triinyti/Guitar_interface/README.md

# Guitar_interface
Custom designed guitar interface for 48kHz/24 bit audio transmission via UAC (USB Audio Class) and mic output.
