triinyti/Guitar_interface/simulation/lin_per_loudness_poti_sim.asc

120: res; 1.5k
I1: current; 1
R1: res; {Rother}
R2: res; {Rtap}
R4: res; 470
V1: voltage; 1
Named nets: 0
.param Rother = 10k - Rtap + 0.001
.step param Rtap 0.01 10k 10
.op
;.tf
