triinyti/Guitar_interface/simulation/opamp_audio_pipeline.asc

100: res; 100
C1: cap; 470µ
C2: cap; 100n
C3: cap; 100n
C4: cap; 560n; Rser=0.001
C5: cap; 68n
C6: cap; 330n
C7: cap; 47n
C8: cap; 10µ
C9: cap; 1µ
C10: cap; 1n
C11: cap; 470p
C12: cap; 280p
C13: cap; 560p
C14: cap; 100µ
C15: cap; 10n
C16: cap; 100n
C17: cap; 10µ
C18: cap; 1µ
C19: cap; 1n
D1: schottky; BAT54
D2: schottky; BAT54
D3: schottky; BAT54
D4: schottky; BAT54
D5: diode
D7: LED
I1: current; ""; AC 1
M1: nmos; BSP89
R1: res; 1k
R2: res; {Rin1}
R3: res; 100
R4: res; 2.2k
R5: res; 49k
R6: res; 1k
R7: res; 1k
R8: res; 49k
R9: res; 10k
R10: res; 10k
R11: res; 2.2k
R12: res; 1k
R13: res; 0.18k
R14: res; 0.18k
R15: res; {Rin2}
R16: res; 0.18k
R17: res; 0.18k
R18: res; 0.18k
R19: res; {Rin3}
R20: res; 0.18k
R21: res; 1k
R22: res; {Rout1}
R23: res; {Rout2}
R24: res; {Rout3}
R25: res; 1Meg
R26: res; {Rout4}
R27: res; {Rin4}
R28: res; 100k
R29: res; 22k
R30: res; 1k
R31: res; 1k
R32: res; 15k
R33: res; 100
R34: res; 130
R35: res; 1.8Meg
R36: res; 10k
R37: res; 20k
R38: res; 20k
R39: res; 10k
R40: res; 470
R41: res; 1.5k
R42: res; 10k
R43: res; 1Meg
R44: res; 75k
R45: res; 10.2k
Rbase: res; 100
U1: OPAx134
U2: OPAx134
U4: OPAx134
U5: LTC1440
U6: OPAx134
U7: OPAx134
U9: OPAx134
U10: OPAx134
U12: OPAx134
V1: voltage; SINE(0 2 {fq} 0 0 0); AC 0.05
V2: voltage; 5
V3: voltage; 5
V4: voltage; 2
V5: voltage; 5
V6: voltage; SINE(0 0.04 1000)
V7: voltage; SINE(0 0.04 10000)
V9: voltage; 3.3
Named nets: out, 0, vp, vn, clamp, attenuator, 3.3, clipping_detection, adc_buffer, adc, vadc
.ac lin 100000 0.001 20000
.tran 0 {t_stop} {t_start} 0.001
remove when measuring output impedance
.param Rout1 = maxval - Rin1 + 0.001
.param Rout2 = maxval - Rin2 + 0.001
.param Rout3 = maxval - Rin3 + 0.001
.param maxval = 10.0000k
.param Rin1 = 5k
.param Rin2 = 5k
.param Rin3 = 5k
Input buffer with 1Meg Ohm 
resistor in order not to load the guitar pickups
.param fq = 20
.param Rout4 = 10k - Rin4 + 0.001
.param Rin4=10k
Clipping detection: charge RC-network R29//C8 when clipping. 
Use voltage to trigger a LED to light up.
Precision voltage clamp for a couple of mV
3 band active equilizer
Attenuation for the aux mic input
.param t_start = 0
.param t_stop = t_start + t_show
.param t_show = 0.5
connecting this makes the simulation stop working because something
makes it take extremly long. Should work in theory and simulations 
before adding the adc section showed good results.
use fdv301n
