triinyti/Guitar_interface/simulation/pmos_en_vdd.asc

M1: pmos; Si1013
R1: res; 330
R2: res; 10k
R3: res; 100
V1: voltage; 3.3
V2: voltage; PULSE(3.3 0 1 10n 10n 5 0 1)
Named nets: 0
.tran 0 10 0
