triinyti/Guitar_interface/simulation/powersupply_opamp.asc

C1: cap; 4.7µ
C2: cap; 4.7µ
C3: cap; 2.2n
C4: cap; 100n
C5: cap; 47p
C6: cap; 1n
C7: cap; 10µ; IC=0
C8: cap; 4.7µ
C9: cap; 100n
C10: cap; 2.2n
C11: cap; 1µ
C12: cap; 4.7µ; Rser=10m
C13: cap; 4.7µ
C14: cap; 10µ
C15: cap; 1n
C16: cap; 100n
C17: cap; 4.7µ; Rser=0.5
C18: cap; 22µ
C19: cap; 1µ
C20: cap; 1n
C21: cap; 10µ
C22: cap; 4.7µ
D1: schottky; MBR0520L
D2: schottky; MBR0520L
L1: ind; 22µ; Rser=250m
L2: ind; 22µ; Rser=250m
L3: ind; 22µ; Rser=250m
L4: ind; 22µ; Rser=250m
L5: FerriteBead; 230n; Ipk=4 Rser=0.02 Rpar=145 Cpar=6f
R1: res; 68k
R2: res; 10k
R3: res; 68k
R4: res; 30k
R5: res; 10k
R6: res; 126
R7: res; 68k
R8: res; 10k
R9: res; 68k
R10: res; 500
R11: res; 22
R12: res; 126
U1: LT3580
U2: LT1763
U3: LT3580
U4: LT1964-5
U5: LT1790-5
U6: LT1763-3.3
V1: voltage; 5
V2: voltage; PULSE(0 3.3 20m 10n 10n 1)
Named nets: 0, vout, vin, 5vopv, 5vadc, 3.3vdigital, -5vopv
.tran 0 100m 0 1e-4
