triinyti/Guitar_interface/schematic/guitar_interface/guitar_interface.kicad_pcb

## KiCad design schematic/guitar_interface/guitar_interface.kicad_pcb (2026-02-12)

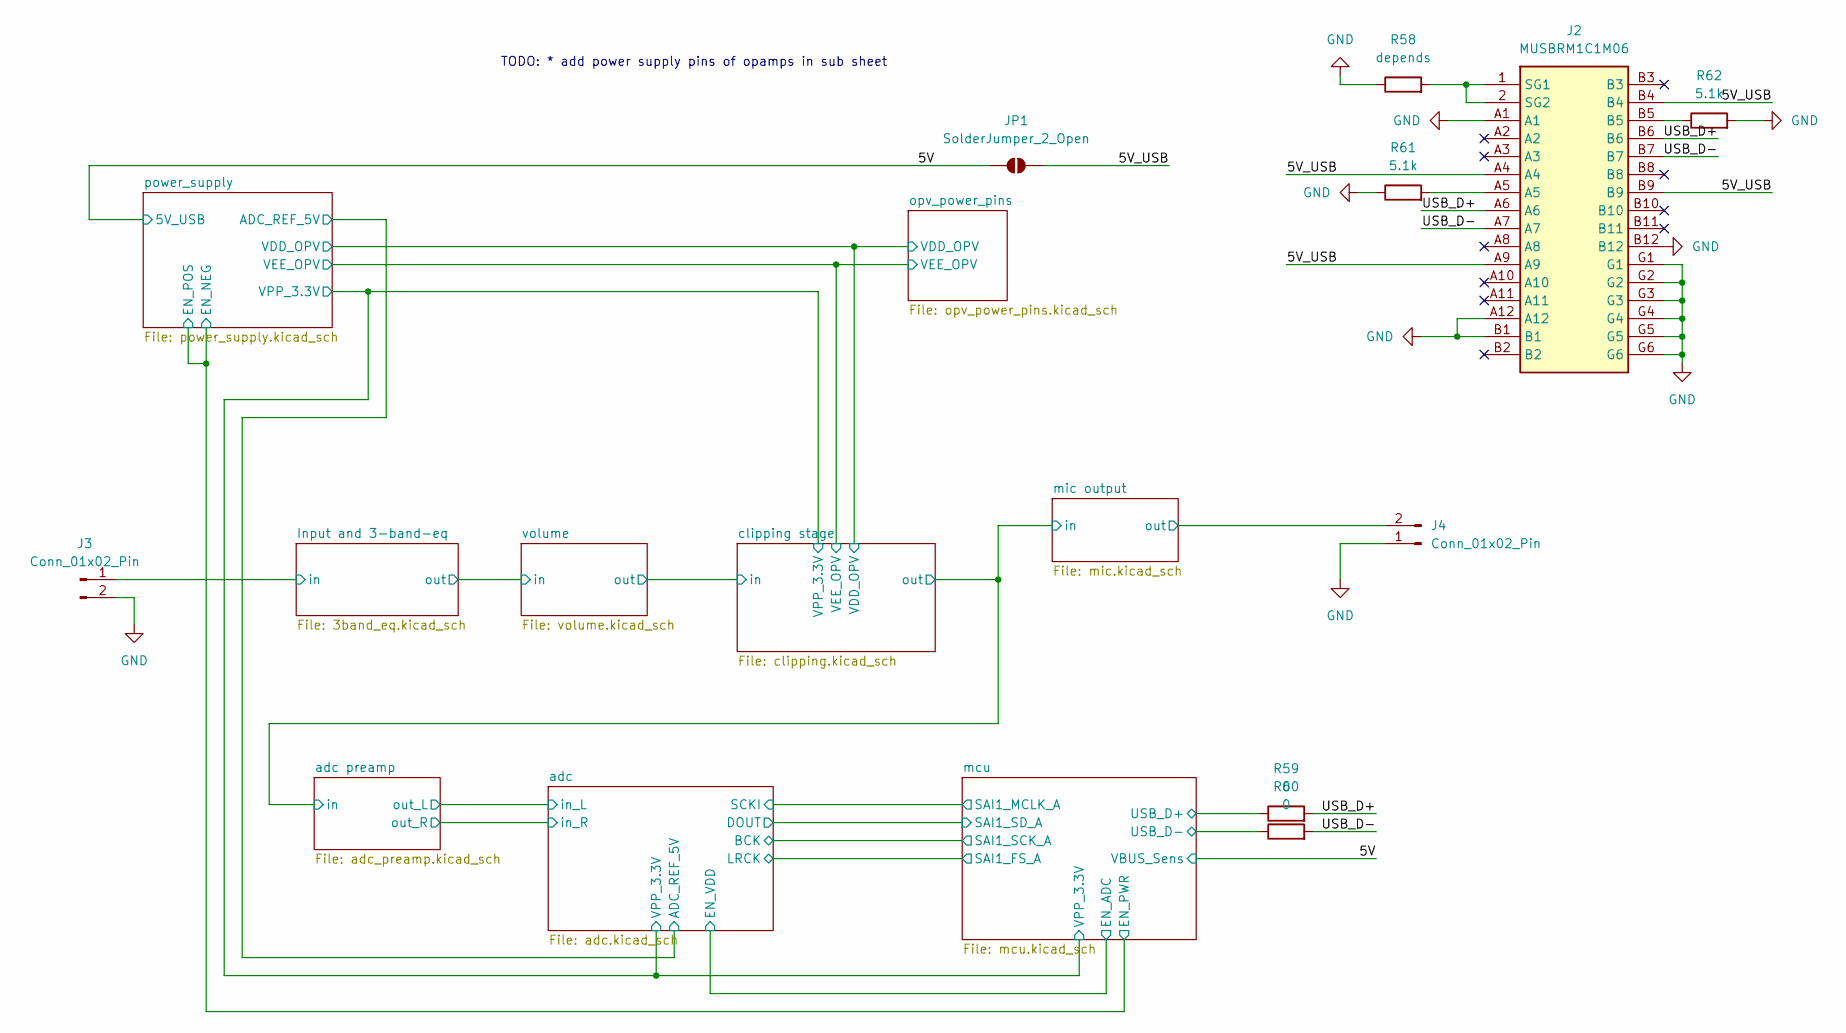
[picture p1: schematic guitar_interface.kicad_sch]

Parts:
J2: MUSBRM1C1M06; Mouser Part Number 523-MUSBRM1C1M06
J3, J4: Conn_01x02_Pin; PinSocket_1x02_P2.54mm_Vertical
JP1: SolderJumper_2_Open; SolderJumper-2_P1.3mm_Open_RoundedPad1.0x1.5mm
R58: depends; R_0603_1608Metric_Pad0.98x0.95mm_HandSolder
R59, R60: 0; R_0603_1608Metric_Pad0.98x0.95mm_HandSolder
R61, R62: 5.1k; R_0603_1608Metric_Pad0.98x0.95mm_HandSolder

Connections:
/5V: JP1.1 (A); also elsewhere on the board
/5V_USB: J2.A4, J2.A9, J2.B4, J2.B9, JP1.2 (B)
/Input and 3-band-eq/in: J3.1; also elsewhere on the board
/USB_D+: J2.A6, J2.B6, R59.2
/USB_D-: J2.A7, J2.B7, R60.2
/mcu/USB_D+: R59.1; also elsewhere on the board
/mcu/USB_D-: R60.1; also elsewhere on the board
/mic output/out: J4.2; also elsewhere on the board
GND: J2.A1, J2.A12, J2.B1, J2.B12, J2.G1, J2.G2, J2.G3, J2.G4, J2.G5, J2.G6, J3.2, J4.1, R58.1, R61.1, R62.2; also elsewhere on the board
unnamed: J2.A5, R61.2
unnamed: J2.B5, R62.1
unnamed: J2.1 (SG1), J2.2 (SG2), R58.2

Notes on the sheet:
TODO: * add power supply pins of opamps in sub sheet

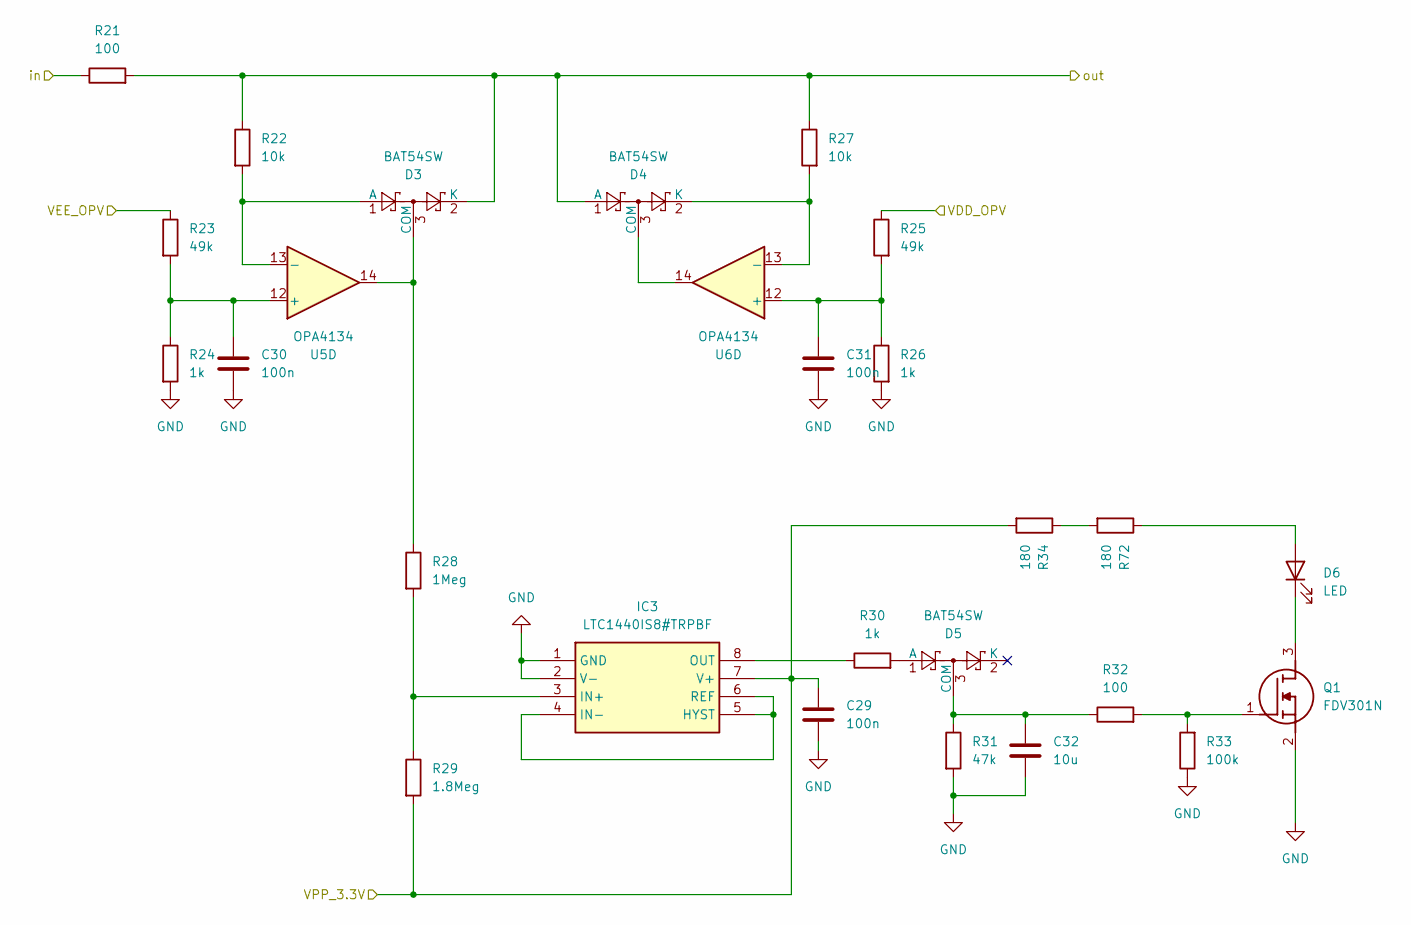
[picture p2: schematic clipping.kicad_sch]

Parts:
C29, C30, C31: 100n; C_0402_1005Metric_Pad0.74x0.62mm_HandSolder
C32: 10u; C_0603_1608Metric_Pad1.08x0.95mm_HandSolder
D3, D4, D5: BAT54SW; SOT-323_SC-70
D6: LED; LED_0603_1608Metric_Pad1.05x0.95mm_HandSolder
IC3: LTC1440IS8#TRPBF; SOIC127P599X175-8N; Mouser Part Number 584-LTC1440IS8#TRPBF
Q1: FDV301N; SOT96P237X111-3N; Mouser Part Number 512-FDV301N
R21, R32: 100; R_0603_1608Metric_Pad0.98x0.95mm_HandSolder
R22, R27: 10k; R_0603_1608Metric_Pad0.98x0.95mm_HandSolder
R23, R25: 49k; R_0603_1608Metric_Pad0.98x0.95mm_HandSolder
R24, R26, R30: 1k; R_0603_1608Metric_Pad0.98x0.95mm_HandSolder
R28: 1Meg; R_0603_1608Metric_Pad0.98x0.95mm_HandSolder
R29: 1.8Meg; R_0603_1608Metric_Pad0.98x0.95mm_HandSolder
R31: 47k; R_0603_1608Metric_Pad0.98x0.95mm_HandSolder
R33: 100k; R_0603_1608Metric_Pad0.98x0.95mm_HandSolder
R34, R72: 180; R_0603_1608Metric_Pad0.98x0.95mm_HandSolder
U5, U6: OPA4134; SOIC-14_3.9x8.7mm_P1.27mm

Connections:
/adc preamp/in: D3.2 (K), D4.1 (A), R21.2, R22.1, R27.1; also elsewhere on the board
/adc/VPP_3.3V: C29.1, IC3.7 (V+), R29.2, R34.2; also elsewhere on the board
/clipping stage/VDD_OPV: R25.1; also elsewhere on the board
/clipping stage/VEE_OPV: R23.1; also elsewhere on the board
/clipping stage/in: R21.1; also elsewhere on the board
GND: C29.2, C30.2, C31.2, C32.2, IC3.1 (GND), IC3.2 (V-), Q1.2 (S), R24.2, R26.2, R31.2, R33.1; also elsewhere on the board
unnamed: D3.1 (A), R22.2, U5.13 (-)
unnamed: D3.3 (COM), R28.1, U5.14
unnamed: D4.3 (COM), U6.14
unnamed: D4.2 (K), R27.2, U6.13 (-)
unnamed: D5.1 (A), R30.2
unnamed: C32.1, D5.3 (COM), R31.1, R32.1
unnamed: D6.2 (A), R72.1
unnamed: D6.1 (K), Q1.3 (D)
unnamed: IC3.4 (IN-), IC3.5 (HYST), IC3.6 (REF)
unnamed: IC3.3 (IN+), R28.2, R29.1
unnamed: IC3.8 (OUT), R30.1
unnamed: Q1.1 (G), R32.2, R33.2
unnamed: R34.1, R72.2
unnamed: C30.1, R23.2, R24.1, U5.12 (+)
unnamed: C31.1, R25.2, R26.1, U6.12 (+)

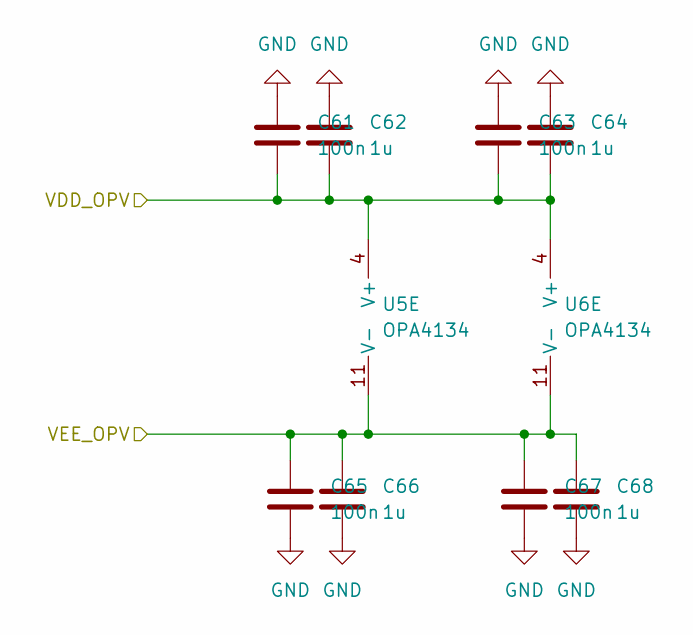
[picture p3: schematic opv_power_pins.kicad_sch]

Parts:
C61, C63, C65, C67: 100n; C_0402_1005Metric_Pad0.74x0.62mm_HandSolder
C62, C64, C66, C68: 1u; C_0603_1608Metric_Pad1.08x0.95mm_HandSolder
U5, U6: OPA4134; SOIC-14_3.9x8.7mm_P1.27mm

Connections:
/clipping stage/VDD_OPV: C61.2, C62.2, C63.2, C64.2, U5.4 (V+), U6.4 (V+); also elsewhere on the board
/clipping stage/VEE_OPV: C65.1, C66.1, C67.1, C68.1, U5.11 (V-), U6.11 (V-); also elsewhere on the board
GND: C61.1, C62.1, C63.1, C64.1, C65.2, C66.2, C67.2, C68.2; also elsewhere on the board

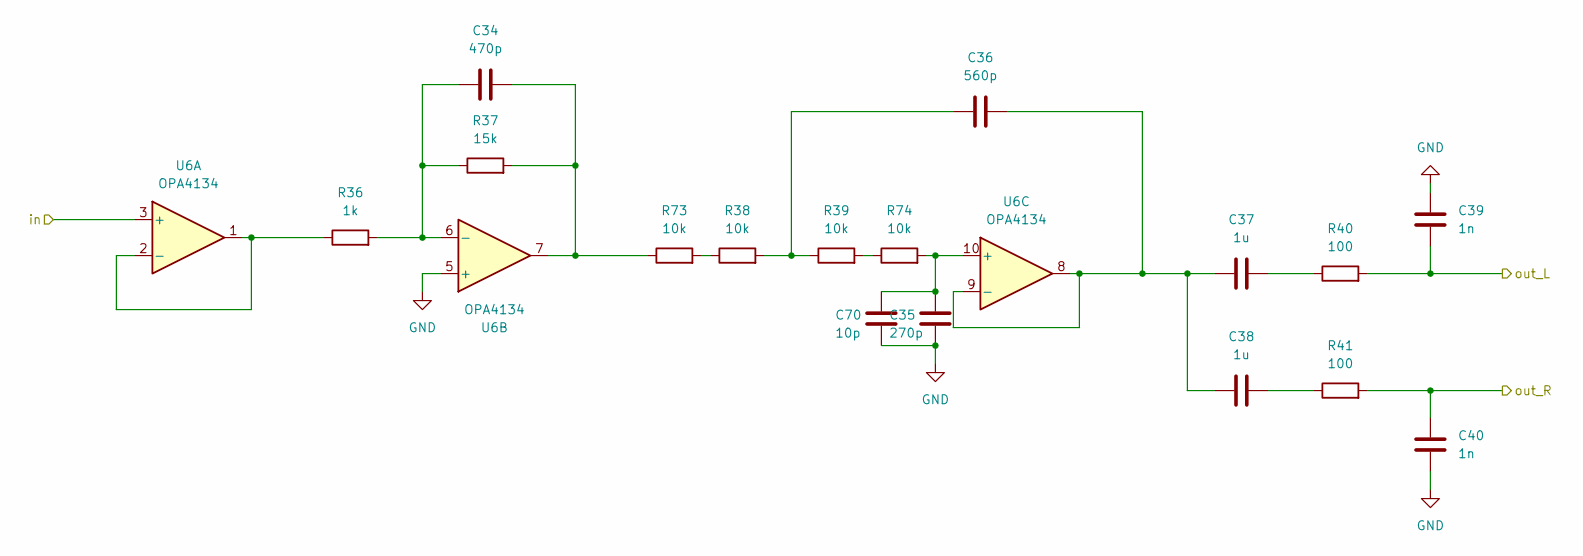
[picture p4: schematic adc_preamp.kicad_sch]

Parts:
C34: 470p; C_0603_1608Metric_Pad1.08x0.95mm_HandSolder
C35: 270p; C_0402_1005Metric_Pad0.74x0.62mm_HandSolder
C36: 560p; C_0805_2012Metric_Pad1.18x1.45mm_HandSolder
C37, C38: 1u; C_0603_1608Metric_Pad1.08x0.95mm_HandSolder
C39, C40: 1n; C_0402_1005Metric_Pad0.74x0.62mm_HandSolder
C70: 10p; C_0603_1608Metric_Pad1.08x0.95mm_HandSolder
R36: 1k; R_0603_1608Metric_Pad0.98x0.95mm_HandSolder
R37: 15k; R_0603_1608Metric_Pad0.98x0.95mm_HandSolder
R38, R39, R73, R74: 10k; R_0603_1608Metric_Pad0.98x0.95mm_HandSolder
R40, R41: 100; R_0603_1608Metric_Pad0.98x0.95mm_HandSolder
U6: OPA4134; SOIC-14_3.9x8.7mm_P1.27mm

Connections:
/adc preamp/in: U6.3 (+); also elsewhere on the board
/adc preamp/out_L: C39.1, R40.2; also elsewhere on the board
/adc preamp/out_R: C40.2, R41.2; also elsewhere on the board
GND: C35.2, C39.2, C40.1, C70.2, U6.5 (+); also elsewhere on the board
unnamed: C34.2, R37.2, R73.1, U6.7
unnamed: C36.1, R38.2, R39.1
unnamed: C37.2, R40.1
unnamed: C38.2, R41.1
unnamed: R38.1, R73.2
unnamed: R39.2, R74.1
unnamed: R36.1, U6.1, U6.2 (-)
unnamed: C34.1, R36.2, R37.1, U6.6 (-)
unnamed: C35.1, C70.1, R74.2, U6.10 (+)
unnamed: C36.2, C37.1, C38.1, U6.8, U6.9 (-)

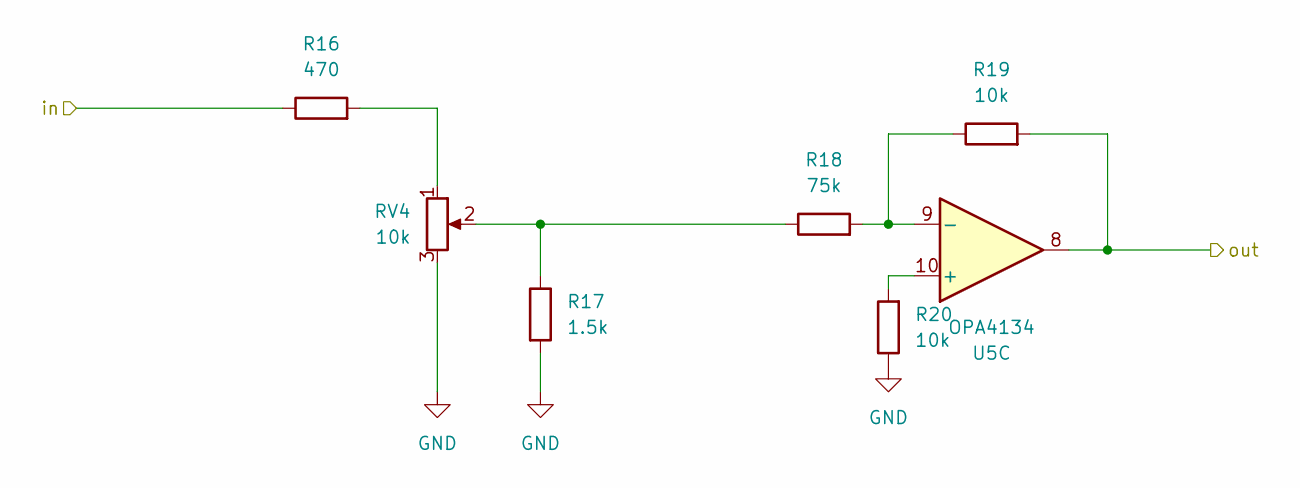
[picture p5: schematic volume.kicad_sch]

Parts:
R16: 470; R_0603_1608Metric_Pad0.98x0.95mm_HandSolder
R17: 1.5k; R_0603_1608Metric_Pad0.98x0.95mm_HandSolder
R18: 75k; R_0603_1608Metric_Pad0.98x0.95mm_HandSolder
R19, R20: 10k; R_0603_1608Metric_Pad0.98x0.95mm_HandSolder
RV4: 10k; PinHeader_1x03_P2.54mm_Vertical
U5: OPA4134; SOIC-14_3.9x8.7mm_P1.27mm

Connections:
/Input and 3-band-eq/out: R16.1; also elsewhere on the board
/clipping stage/in: R19.2, U5.8; also elsewhere on the board
GND: R17.2, R20.1, RV4.3; also elsewhere on the board
unnamed: R16.2, RV4.1
unnamed: R17.1, R18.1, RV4.2
unnamed: R20.2, U5.10 (+)
unnamed: R18.2, R19.1, U5.9 (-)

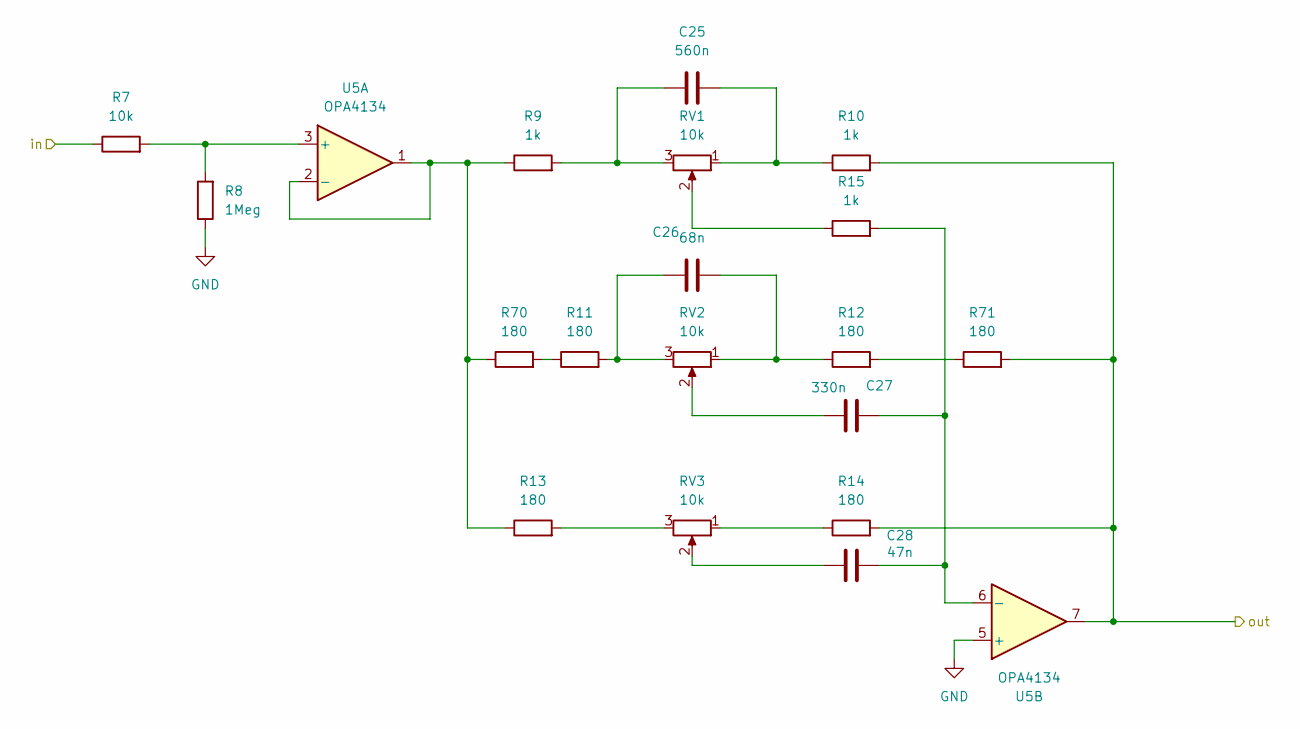
[picture p6: schematic 3band_eq.kicad_sch]

Parts:
C25: 560n; C_0805_2012Metric_Pad1.18x1.45mm_HandSolder
C26: 68n; C_0805_2012Metric_Pad1.18x1.45mm_HandSolder
C27: 330n; C_0805_2012Metric_Pad1.18x1.45mm_HandSolder
C28: 47n; C_0603_1608Metric_Pad1.08x0.95mm_HandSolder
R7: 10k; R_0603_1608Metric_Pad0.98x0.95mm_HandSolder
R8: 1Meg; R_0603_1608Metric_Pad0.98x0.95mm_HandSolder
R9, R10, R15: 1k; R_0603_1608Metric_Pad0.98x0.95mm_HandSolder
R11, R12, R13, R14, R70, R71: 180; R_0603_1608Metric_Pad0.98x0.95mm_HandSolder
RV1, RV2, RV3: 10k; PinHeader_1x03_P2.54mm_Vertical
U5: OPA4134; SOIC-14_3.9x8.7mm_P1.27mm

Connections:
/Input and 3-band-eq/in: R7.1; also elsewhere on the board
/Input and 3-band-eq/out: R10.2, R14.2, R71.2, U5.7; also elsewhere on the board
GND: R8.1, U5.5 (+); also elsewhere on the board
unnamed: C25.1, R9.2, RV1.3
unnamed: C25.2, R10.1, RV1.1
unnamed: C26.1, R11.2, RV2.3
unnamed: C26.2, R12.1, RV2.1
unnamed: C27.1, RV2.2
unnamed: C28.1, RV3.2
unnamed: R11.1, R70.2
unnamed: R12.2, R71.1
unnamed: R13.2, RV3.3
unnamed: R14.1, RV3.1
unnamed: R15.1, RV1.2
unnamed: R7.2, R8.2, U5.3 (+)
unnamed: R9.1, R13.1, R70.1, U5.1, U5.2 (-)
unnamed: C27.2, C28.2, R15.2, U5.6 (-)

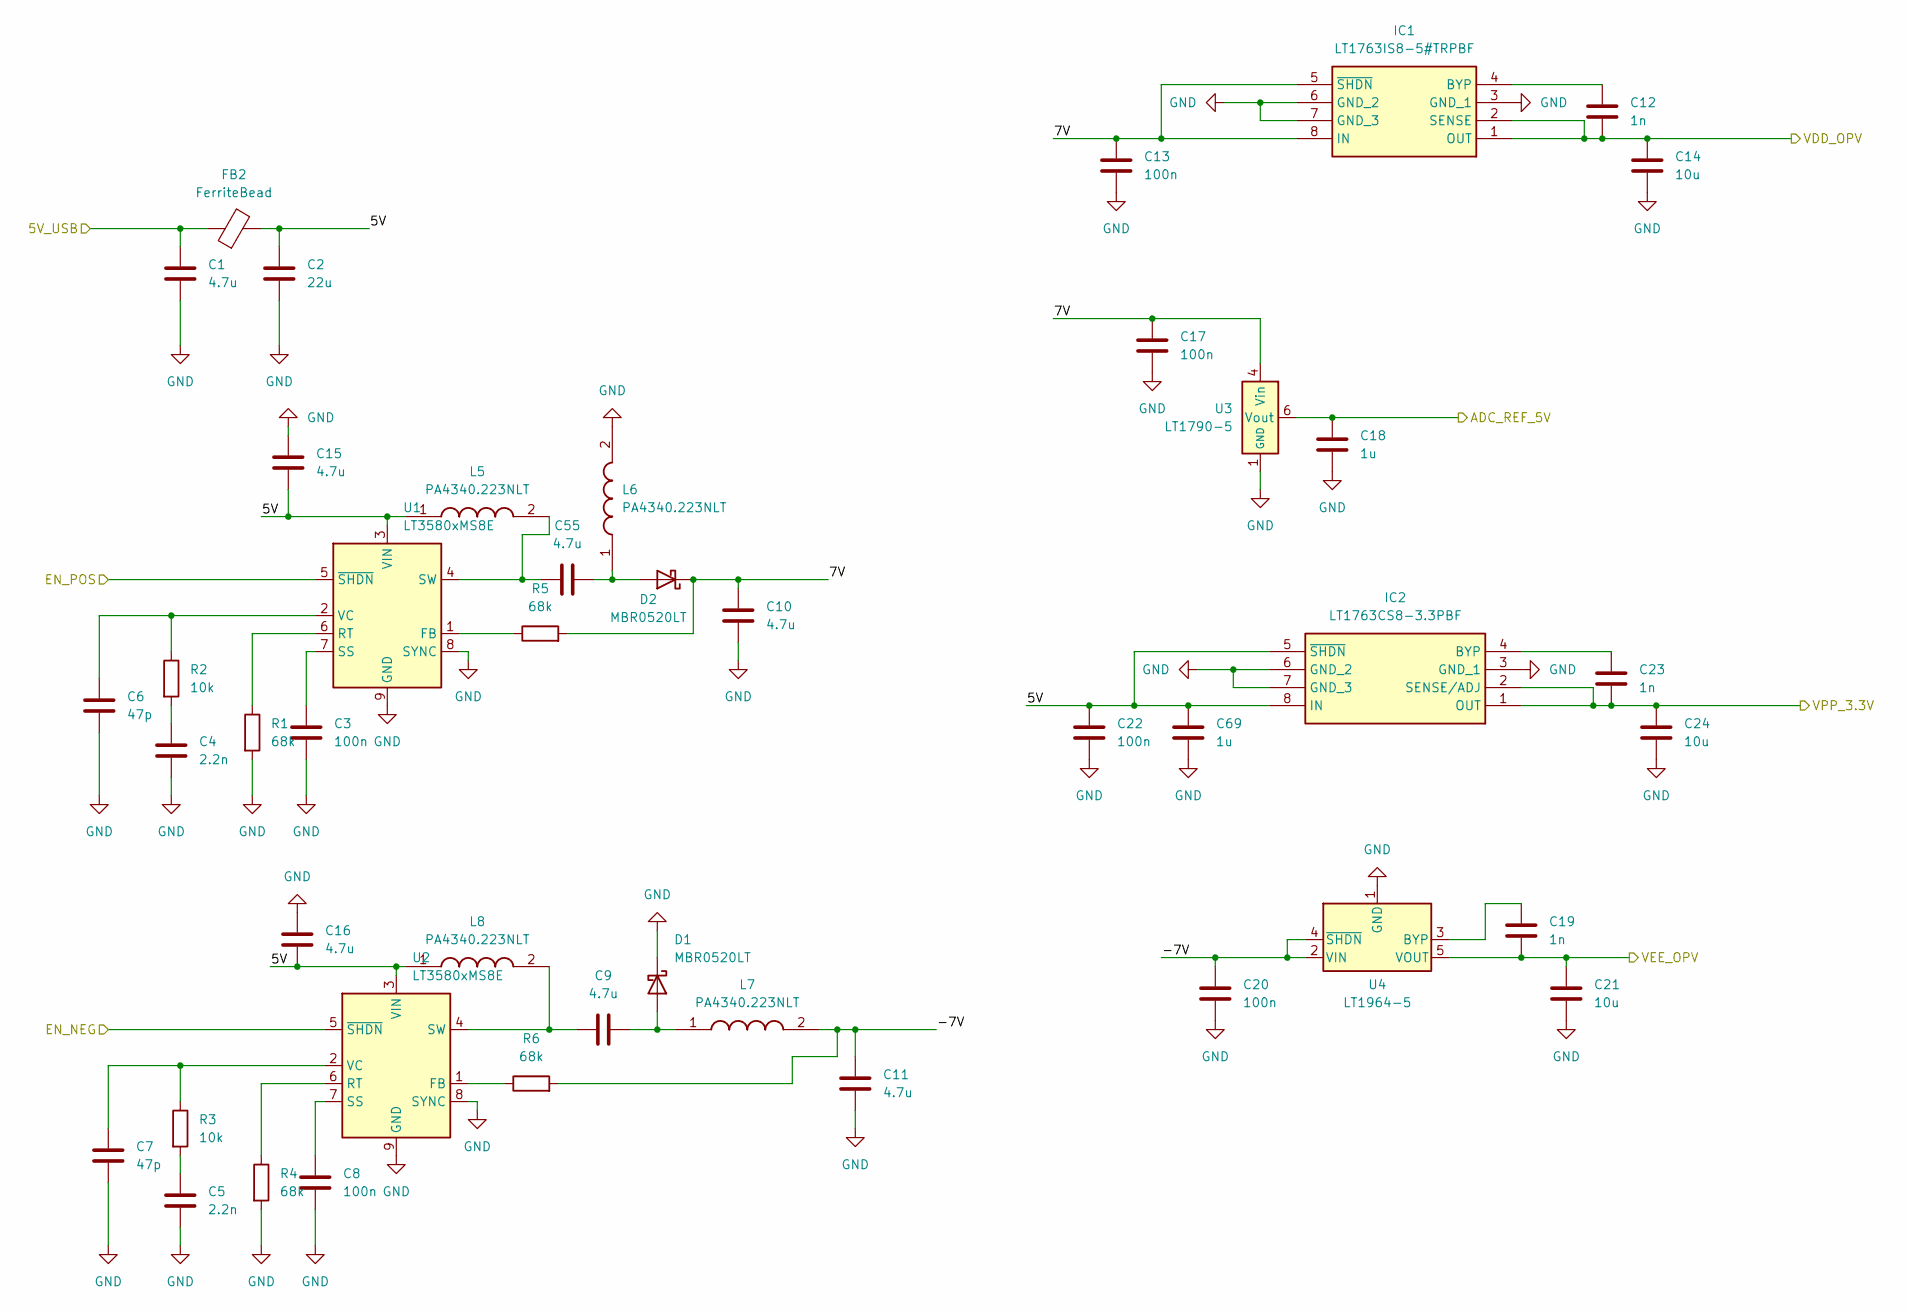
[picture p7: schematic power_supply.kicad_sch]

Parts:
C1, C9, C10, C11, C15, C16, C55: 4.7u; C_0805_2012Metric_Pad1.18x1.45mm_HandSolder
C2: 22u; C_0603_1608Metric_Pad1.08x0.95mm_HandSolder
C3, C8, C13, C17, C20, C22: 100n; C_0402_1005Metric_Pad0.74x0.62mm_HandSolder
C4, C5: 2.2n; C_0402_1005Metric_Pad0.74x0.62mm_HandSolder
C6, C7: 47p; C_0402_1005Metric_Pad0.74x0.62mm_HandSolder
C12, C19, C23: 1n; C_0402_1005Metric_Pad0.74x0.62mm_HandSolder
C14, C21, C24: 10u; C_0603_1608Metric_Pad1.08x0.95mm_HandSolder
C18, C69: 1u; C_0603_1608Metric_Pad1.08x0.95mm_HandSolder
D1, D2: MBR0520LT; D_SOD-123
FB2: FerriteBead; R_1206_3216Metric
IC1: LT1763IS8-5#TRPBF; SOIC127P599X175-8N; Mouser Part Number 584-LT1763IS8-5TRPBF
IC2: LT1763CS8-3.3PBF; SOIC127P599X175-8N; Manufacturer_Part_Number LT1763CS8-3.3PBF
L5, L6, L7, L8: PA4340.223NLT; INDPM6054X300N; Mouser Part Number 673-PA4340.223NLT
R1, R4, R5, R6: 68k; R_0603_1608Metric_Pad0.98x0.95mm_HandSolder
R2, R3: 10k; R_0603_1608Metric_Pad0.98x0.95mm_HandSolder
U1, U2: LT3580xMS8E; MSOP-8-1EP_3x3mm_P0.65mm_EP1.68x1.88mm
U3: LT1790-5; TSOT-23-6
U4: LT1964-5; TSOT-23-5

Connections:
/5V: C1.1, FB2.1; also elsewhere on the board
/adc/ADC_REF_5V: C18.1, U3.6 (Vout); also elsewhere on the board
/adc/VPP_3.3V: C23.2, C24.1, IC2.1 (OUT), IC2.2 (SENSE/ADJ); also elsewhere on the board
/clipping stage/VDD_OPV: C12.2, C14.1, IC1.1 (OUT), IC1.2 (SENSE); also elsewhere on the board
/clipping stage/VEE_OPV: C19.2, C21.1, U4.5 (VOUT); also elsewhere on the board
/mcu/EN_PWR: U1.5 (~SHDN), U2.5 (~SHDN); also elsewhere on the board
/power_supply/5V: C2.1, C15.1, C16.1, C22.1, C69.1, FB2.2, IC2.5 (~SHDN), IC2.8 (IN), L5.1, L8.1, U1.3 (VIN), U2.3 (VIN)
/power_supply/7V: C10.2, C13.1, C17.1, D2.1 (K), IC1.5 (~SHDN), IC1.8 (IN), R5.2, U3.4 (Vin)
/power_supply/-7V: C11.2, C20.1, L7.2, R6.2, U4.2 (VIN), U4.4 (~SHDN)
GND: C1.2, C2.2, C3.2, C4.2, C5.2, C6.2, C7.2, C8.2, C10.1, C11.1, C13.2, C14.2, C15.2, C16.2, C17.2, C18.2, C20.2, C21.2, C22.2, C24.2, C69.2, D1.1 (K), IC1.3 (GND_1), IC1.6 (GND_2), IC1.7 (GND_3), IC2.3 (GND_1), IC2.6 (GND_2), IC2.7 (GND_3), L6.2, R1.2, R4.2, U1.8 (SYNC), U1.9 (GND), U2.8 (SYNC), U2.9 (GND), U3.1 (GND), U3.2 (GND), U4.1 (GND); also elsewhere on the board
unnamed: C4.1, R2.2
unnamed: C5.1, R3.2
unnamed: C9.2, D1.2 (A), L7.1
unnamed: C55.1, D2.2 (A), L6.1
unnamed: C12.1, IC1.4 (BYP)
unnamed: C23.1, IC2.4 (BYP)
unnamed: R5.1, U1.1 (FB)
unnamed: R1.1, U1.6 (RT)
unnamed: C3.1, U1.7 (SS)
unnamed: C55.2, L5.2, U1.4 (SW)
unnamed: C6.1, R2.1, U1.2 (VC)
unnamed: R6.1, U2.1 (FB)
unnamed: R4.1, U2.6 (RT)
unnamed: C8.1, U2.7 (SS)
unnamed: C9.1, L8.2, U2.4 (SW)
unnamed: C7.1, R3.1, U2.2 (VC)
unnamed: C19.1, U4.3 (BYP)

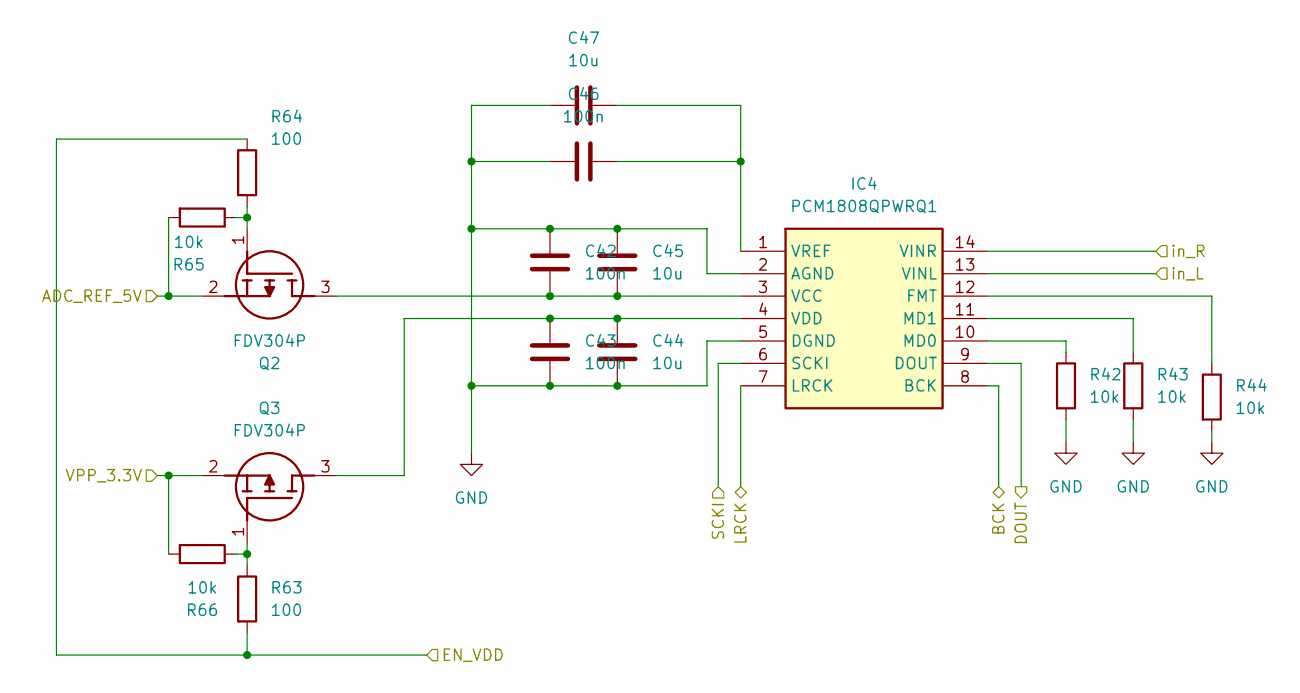
[picture p8: schematic adc.kicad_sch]

Parts:
C42, C43, C46: 100n; C_0402_1005Metric_Pad0.74x0.62mm_HandSolder
C44, C45, C47: 10u; C_0603_1608Metric_Pad1.08x0.95mm_HandSolder
IC4: PCM1808QPWRQ1; SOP65P640X120-14N; Mouser Part Number 595-PCM1808QPWRQ1
Q2, Q3: FDV304P; SOT95P251X112-3N; Mouser Part Number 512-FDV304P
R42, R43, R44, R65, R66: 10k; R_0603_1608Metric_Pad0.98x0.95mm_HandSolder
R63, R64: 100; R_0603_1608Metric_Pad0.98x0.95mm_HandSolder

Connections:
/adc preamp/out_L: IC4.13 (VINL); also elsewhere on the board
/adc preamp/out_R: IC4.14 (VINR); also elsewhere on the board
/adc/ADC_REF_5V: Q2.2 (S), R65.2; also elsewhere on the board
/adc/BCK: IC4.8 (BCK); also elsewhere on the board
/adc/DOUT: IC4.9 (DOUT); also elsewhere on the board
/adc/EN_VDD: R63.2, R64.1; also elsewhere on the board
/adc/LRCK: IC4.7 (LRCK); also elsewhere on the board
/adc/SCKI: IC4.6 (SCKI); also elsewhere on the board
/adc/VPP_3.3V: Q3.2 (S), R66.2; also elsewhere on the board
GND: C42.2, C43.1, C44.1, C45.2, C46.2, C47.2, IC4.2 (AGND), IC4.5 (DGND), R42.2, R43.2, R44.2; also elsewhere on the board
unnamed: IC4.12 (FMT), R44.1
unnamed: IC4.10 (MD0), R42.1
unnamed: IC4.11 (MD1), R43.1
unnamed: C42.1, C45.1, IC4.3 (VCC), Q2.3 (D)
unnamed: C43.2, C44.2, IC4.4 (VDD), Q3.3 (D)
unnamed: C46.1, C47.1, IC4.1 (VREF)
unnamed: Q2.1 (G), R64.2, R65.1
unnamed: Q3.1 (G), R63.1, R66.1

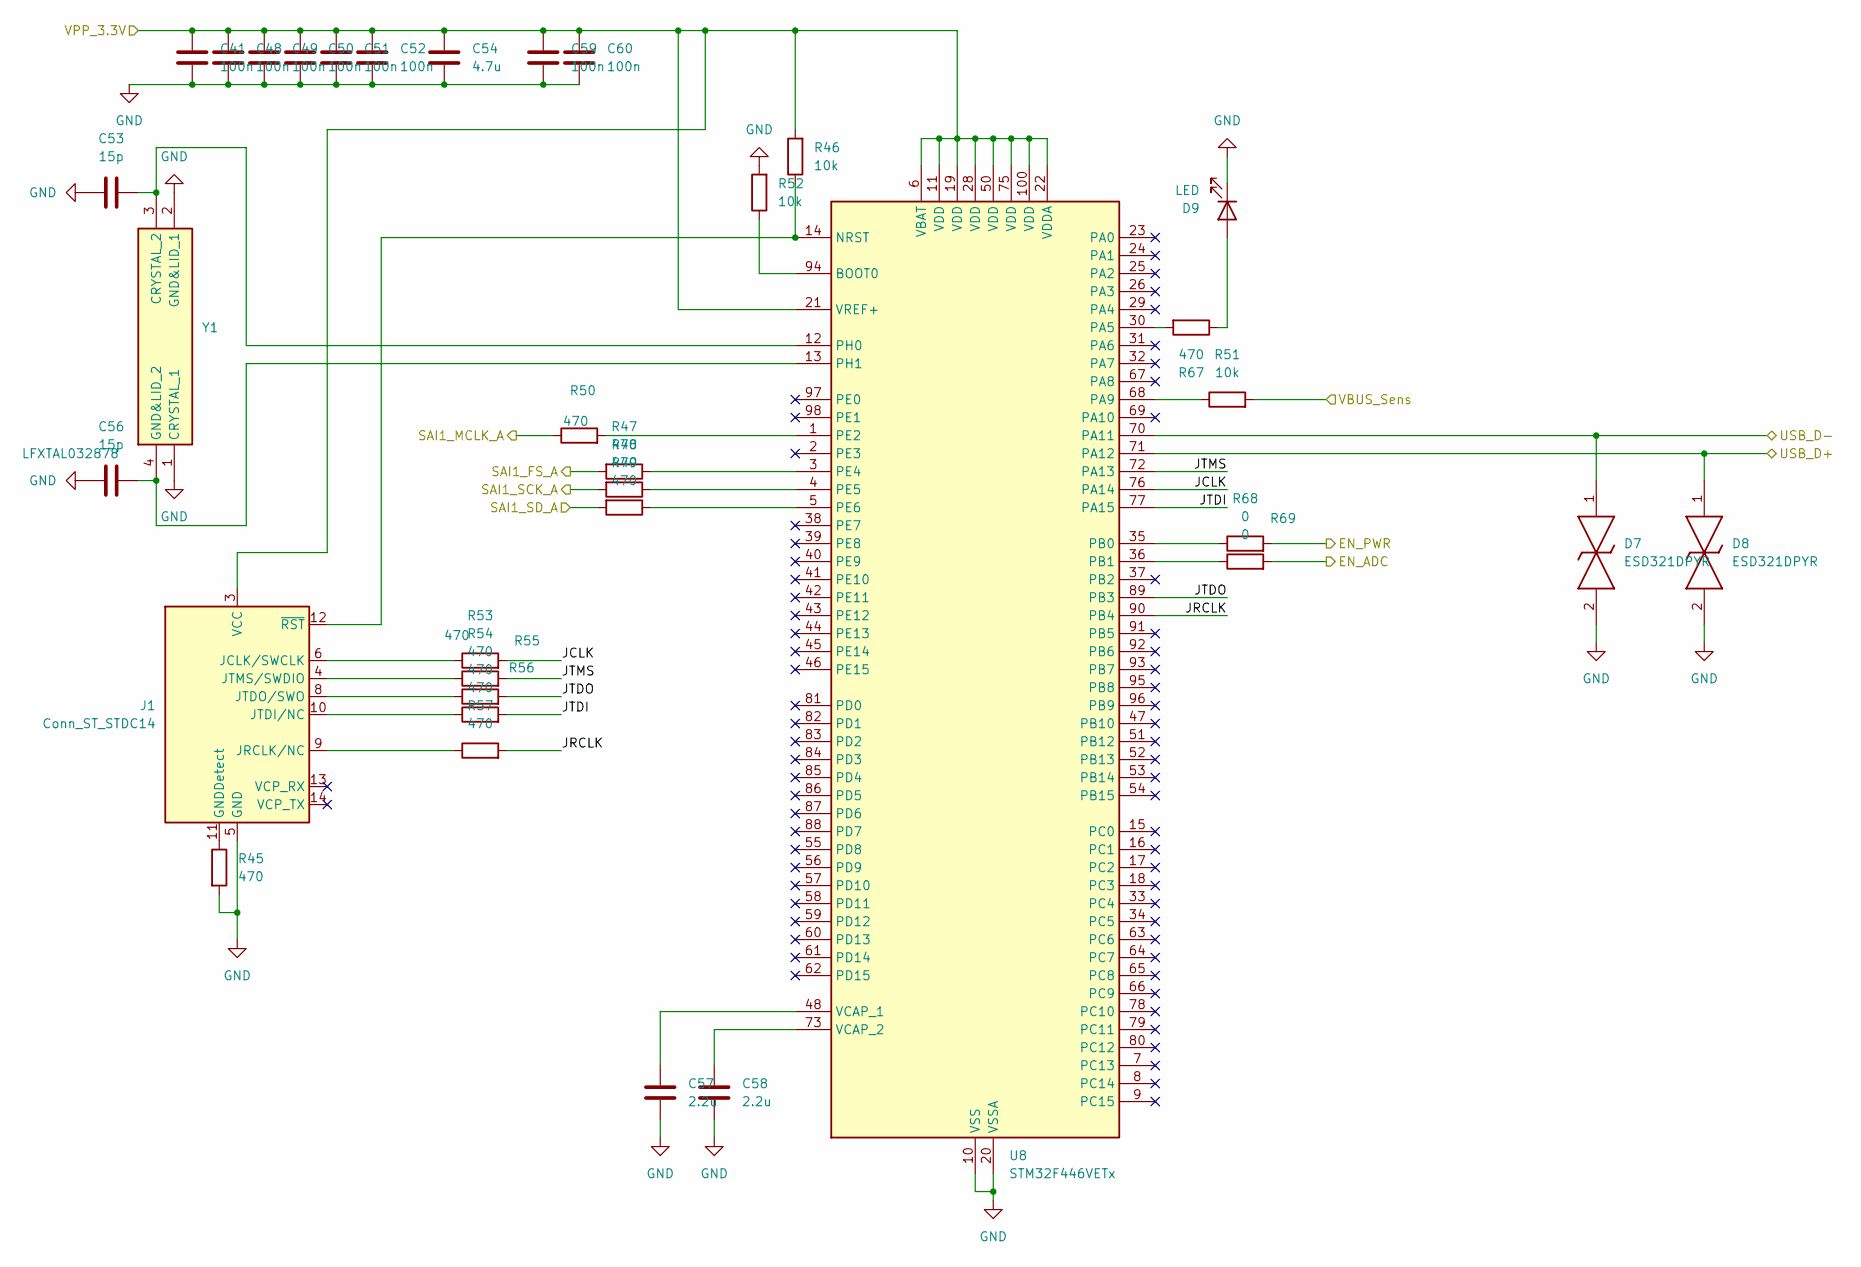
[picture p9: schematic mcu.kicad_sch]

Parts:
C41, C48, C49, C50, C51, C52, C59, C60: 100n; C_0402_1005Metric_Pad0.74x0.62mm_HandSolder
C53, C56: 15p; C_0201_0603Metric_Pad0.64x0.40mm_HandSolder
C54: 4.7u; C_0805_2012Metric_Pad1.18x1.45mm_HandSolder
C57, C58: 2.2u; C_0603_1608Metric_Pad1.08x0.95mm_HandSolder
D7, D8: ESD321DPYR; DPY_R-PX1SON-N2_; Mouser Part Number 595-ESD321DPYR
D9: LED; LED_0603_1608Metric_Pad1.05x0.95mm_HandSolder
J1: Conn_ST_STDC14; FTSH-107-XX-YYY-D-K
R45, R47, R48, R49, R50, R53, R54, R55, R56, R57, R67: 470; R_0603_1608Metric_Pad0.98x0.95mm_HandSolder
R46, R51, R52: 10k; R_0603_1608Metric_Pad0.98x0.95mm_HandSolder
R68, R69: 0; R_0603_1608Metric_Pad0.98x0.95mm_HandSolder
U8: STM32F446VETx; LQFP-100_14x14mm_P0.5mm
Y1: LFXTAL032878; Manufacturer_Part_Number LFXTAL032878

Connections:
/5V: R51.2; also elsewhere on the board
/adc/BCK: R48.2; also elsewhere on the board
/adc/DOUT: R49.2; also elsewhere on the board
/adc/EN_VDD: R69.2; also elsewhere on the board
/adc/LRCK: R47.2; also elsewhere on the board
/adc/SCKI: R50.1; also elsewhere on the board
/adc/VPP_3.3V: C41.1, C48.1, C49.1, C50.1, C51.1, C52.1, C54.1, C59.1, C60.1, J1.3 (VCC), R46.2, U8.6 (VBAT), U8.11 (VDD), U8.19 (VDD), U8.21 (VREF+), U8.22 (VDDA), U8.28 (VDD), U8.50 (VDD), U8.75 (VDD), U8.100 (VDD); also elsewhere on the board
/mcu/EN_PWR: R68.2; also elsewhere on the board
/mcu/JCLK: R53.2, U8.76 (PA14)
/mcu/JRCLK: R57.2, U8.90 (PB4)
/mcu/JTDI: R56.2, U8.77 (PA15)
/mcu/JTDO: R55.2, U8.89 (PB3)
/mcu/JTMS: R54.2, U8.72 (PA13)
/mcu/USB_D+: D8.1, U8.71 (PA12); also elsewhere on the board
/mcu/USB_D-: D7.1, U8.70 (PA11); also elsewhere on the board
GND: C41.2, C48.2, C49.2, C50.2, C51.2, C52.2, C53.1, C54.2, C56.1, C57.2, C58.2, C59.2, C60.2, D7.2, D8.2, D9.1 (K), J1.5 (GND), J1.7 (GND), R45.2, R52.2, U8.10 (VSS), U8.20 (VSSA), U8.27 (VSS), U8.49 (VSS), U8.74 (VSS), U8.99 (VSS), Y1.1 (CRYSTAL_1), Y1.2 (GND&LID_1); also elsewhere on the board
unnamed: D9.2 (A), R67.1
unnamed: J1.11 (GNDDetect), R45.1
unnamed: J1.6 (JCLK/SWCLK), R53.1
unnamed: J1.9 (JRCLK/NC), R57.1
unnamed: J1.10 (JTDI/NC), R56.1
unnamed: J1.8 (JTDO/SWO), R55.1
unnamed: J1.4 (JTMS/SWDIO), R54.1
unnamed: J1.12 (~RST), R46.1, U8.14 (NRST)
unnamed: R52.1, U8.94 (BOOT0)
unnamed: R67.2, U8.30 (PA5)
unnamed: R51.1, U8.68 (PA9)
unnamed: R68.1, U8.35 (PB0)
unnamed: R69.1, U8.36 (PB1)
unnamed: R50.2, U8.1 (PE2)
unnamed: R47.1, U8.3 (PE4)
unnamed: R48.1, U8.4 (PE5)
unnamed: R49.1, U8.5 (PE6)
unnamed: C53.2, U8.12 (PH0), Y1.3 (CRYSTAL_2)
unnamed: C56.2, U8.13 (PH1), Y1.4 (GND&LID_2)
unnamed: C57.1, U8.48 (VCAP_1)
unnamed: C58.1, U8.73 (VCAP_2)

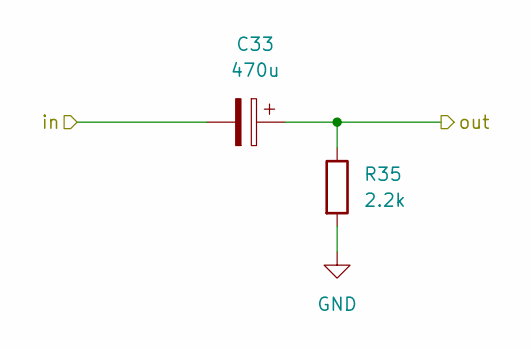
[picture p10: schematic mic.kicad_sch]

Parts:
C33: 470u; CAPAE660X980N
R35: 2.2k; R_0603_1608Metric_Pad0.98x0.95mm_HandSolder

Connections:
/adc preamp/in: C33.2; also elsewhere on the board
/mic output/out: C33.1, R35.1; also elsewhere on the board
GND: R35.2; also elsewhere on the board

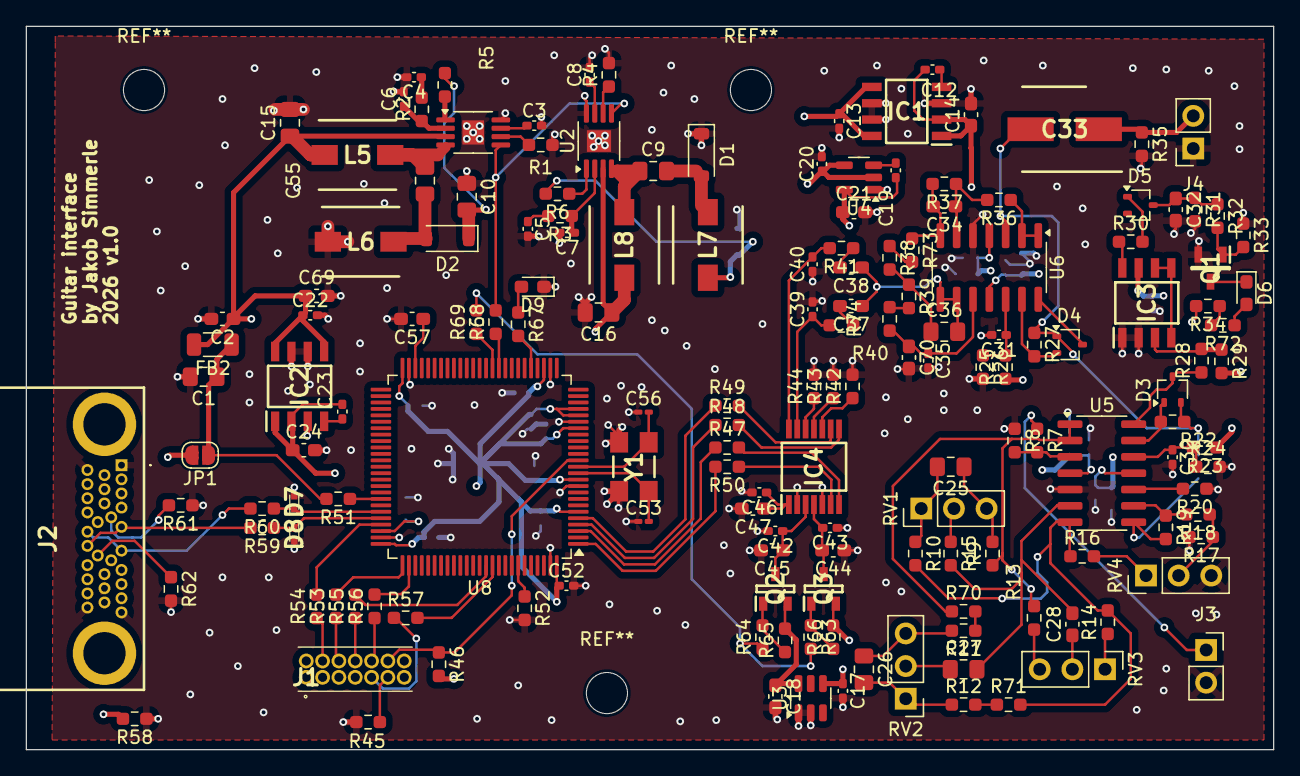
[picture p11: board guitar_interface.kicad_pcb from above]

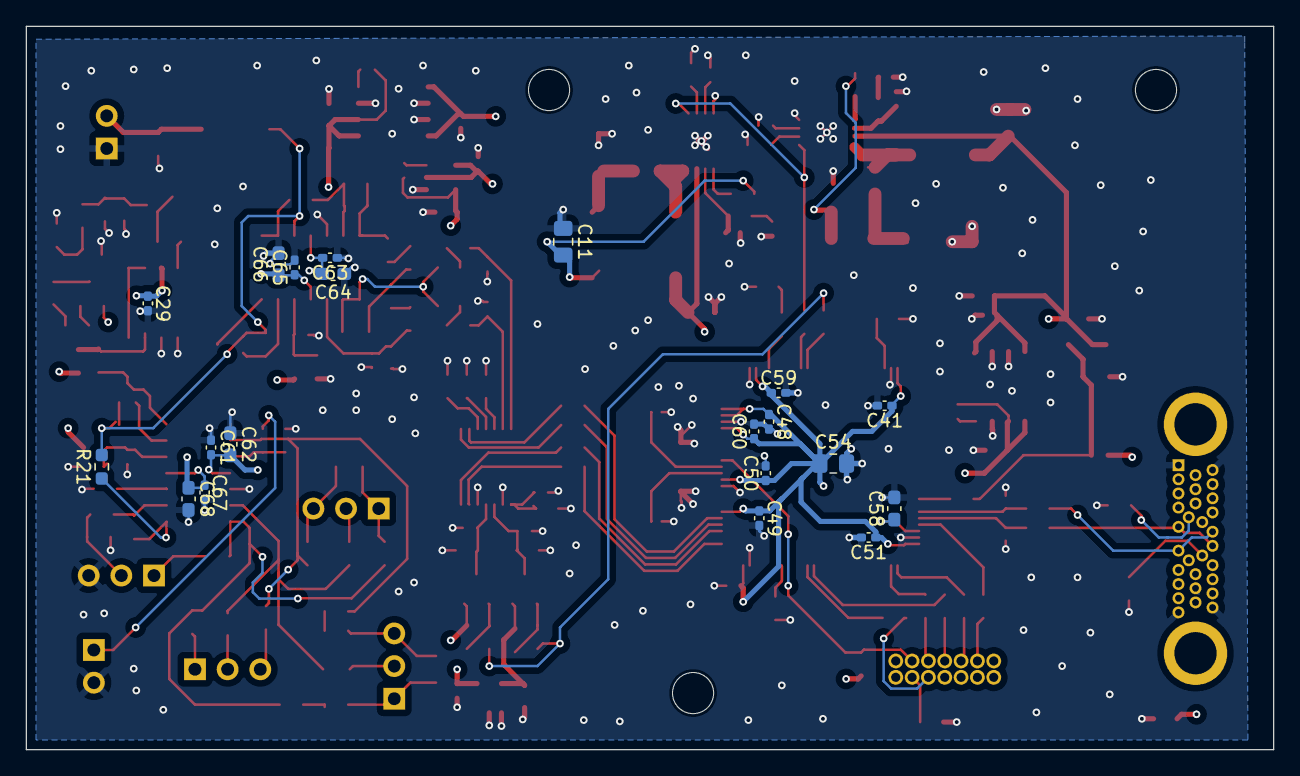
[picture p12: board guitar_interface.kicad_pcb from below]

Board: 4 copper layers, 97.0 x 56.2 mm, 182 parts (20 on the bottom side), 124 nets.
