triinyti/Guitar_interface/(commit log)

2026-02-11 add local files to system
    [3band_eq.kicad_sch, BOM.xlsx, adc.kicad_sch, adc_preamp.kicad_sch, clipping.kicad_sch, guitar_interface.csv, guitar_interface.kicad_pcb, guitar_interface.kicad_sch]
2026-02-11 first scetch of audio pipeline and power supply layout
    [adc_preamp.kicad_sch, guitar_interface.kicad_pcb]
2026-02-12 fix minor issues and do most of the pcb layout
    [guitar_interface.kicad_pcb, mcu.kicad_sch]
2026-02-12 refine layout fix, fix some minor issues, add additional ground planes on all layers, and add mounting holes
    [clipping.kicad_sch, guitar_interface.kicad_pcb, guitar_interface.kicad_sch]
